plusquam/PlusqMoCap_HW/doc/STM32WB/MB1355C Mechanical Dimension.jpg

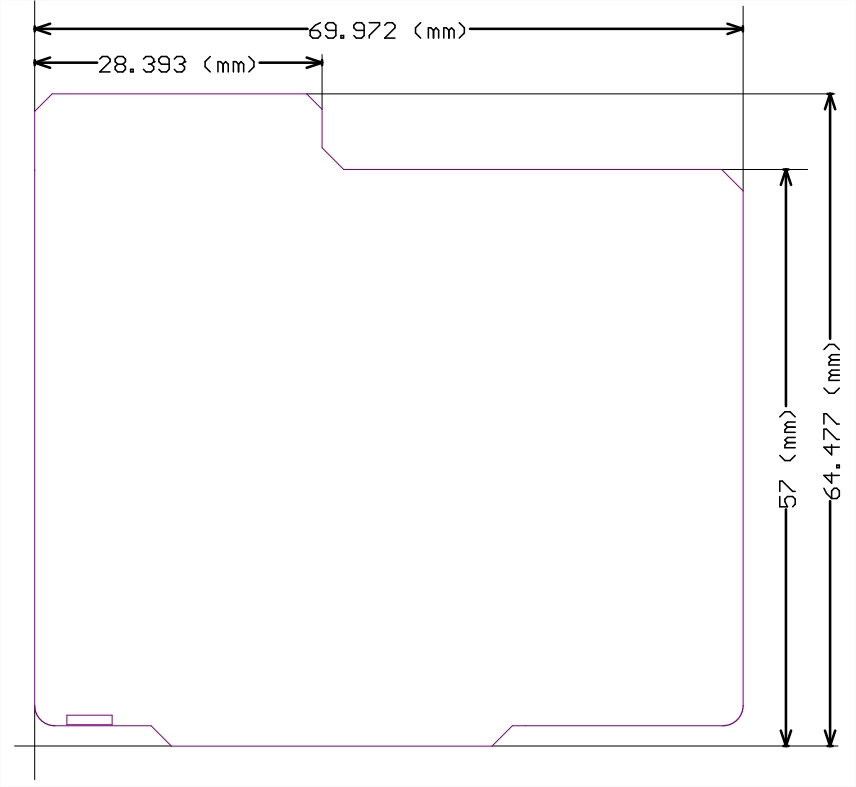
doc/STM32WB/MB1355C Mechanical Dimension.jpg
