plusquam/PlusqMoCap_HW/BOM/main_board_BOM.xlsx

 |  |  | Main Board BOM
Item # | *Ref Des | *Qty | Manufacturer | *Mfg Part # | Description / Value | *Package | Type | Your Instructions / Notes
1 | C1,C2,C3,C4,C5 | 5 | VISHAY | VJ1206V475MXQTW1BC | Ceramic Capacitor, 4.7 µF, Y5V, 10 V | C1206 | SMD | (any/open) Any cheapest and available part which match specification.
2 | D2 | 1 | Vishay | VS-10BQ015-M3/5BT | VS-10BQ015-M3/5BT Vishay SMT Schottky Diode, 15V 1A, 2-Pin DO-214AA (SMB) | DO-214AA | SMD
3 | IC1 | 1 | Microchip | MCP73831T-2ACI/OT | Li-Ion Charge Controller 4.2V SOT23-5 | SOT-23 | SMD
4 | JP1,JP2 | 2 | MULTICOMP | 2212SM-04G-75-B1-PCR | Female pin header (socket), 1x4 slots, pitch 2,54mm | 1X04SMD | SMD | Given device is only example device, it can be replaced with any cheaper and available part which match specification.
5 | L1 | 1 | Bourns | SRN2512-2R2M | Bourns SRN2512 Series Shielded Wire-wound SMD Inductor with a Ferrite Core, 2.2 uH +/-20% 2.3A Idc | INDPM2622X120N | SMD | Given device is only example device, it can be replaced with any cheaper and available part which match specification.
6 | LED1 | 1 | KINGBRIGHT | KPT-3216SGC | Green LED in 1206 package, If = 20mA, Vf = 2,2V | 1206 | SMD | Given device is only example device, it can be replaced with any cheaper and available part which match specification.
7 | R1 | 1 |  |  | 100kOhm, Thick Film Chip Resistor, 1% tolerance, Max. Dissipation 250mW | R1206 | SMD | (any/open) Any cheapest and available part which match specification.
8 | R2,R5 | 2 |  |  | 10kOhm, Thick Film Chip Resistor, 1% tolerance, Max. Dissipation 250mW | R1206 | SMD | (any/open) Any cheapest and available part which match specification.
9 | R3 | 1 |  |  | 150Ohm, Thick Film Chip Resistor, 1% tolerance, Max. Dissipation 250mW | R1206 | SMD | (any/open) Any cheapest and available part which match specification.
10 | R4 | 1 |  |  | 402kOhm, Thick Film Chip Resistor, 1% tolerance, Max. Dissipation 250mW | R1206 | SMD | (any/open) Any cheapest and available part which match specification.
11 | S1 | 1 | EOZ | 09.03201.02 | 2 Way Through Hole SIP Switch SPST, 500mA, 12Vdc | 3POS | thru-hole | Given device is only example device, it can be replaced with any cheaper and available part which match specification.
12 | U$2 | 1 | TEXAS INSTRUMENTS | TLV62568DRLT | DC-DC buck converter | SOT563 | SMD
13 | U$4 | 1 | AMP - TE CONNECTIVITY | 1-2178711-0 | Headers & Wire Housings FOB, SMD, 10P, Pitch: 1,27mm | 2x5POS | SMD | Given device is only example device, it can be replaced with any cheaper and available part which match specification.
14 | U$5 | 1 | NEXPERIA | 74AHC126D,118 | Buffers & Line Drivers QUAD 3-STATE BUS BUF | SOIC-14 | SMD | Given device is only example device, it can be replaced with any cheaper and available part which match specification.
15 | CN7,CN10 | 2 |  |  | Female pin header (socket), 2x19 (38) slots, pitch 2,54mm | 2X19SMD | SMD | (any/open) Any cheapest and available part which match specification.
 | SUM | 22
