plusquam/PlusqMoCap_HW/case/Main board/Main_Board_Top.stl

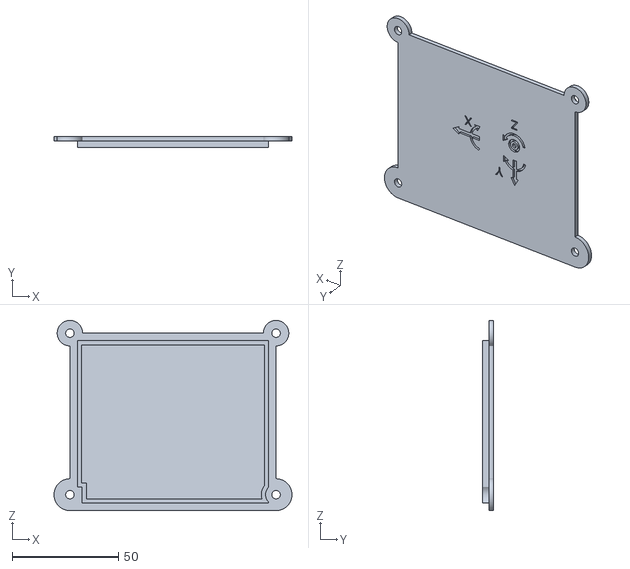
[picture p2: CAD file, 2019-09-26]
case/Main board/Main_Board_Top.stl
112.0 x 5.00 x 89.5
