plusquam/PlusqMoCap_HW/case/Main board/CCR10S_Main_Board.3mf

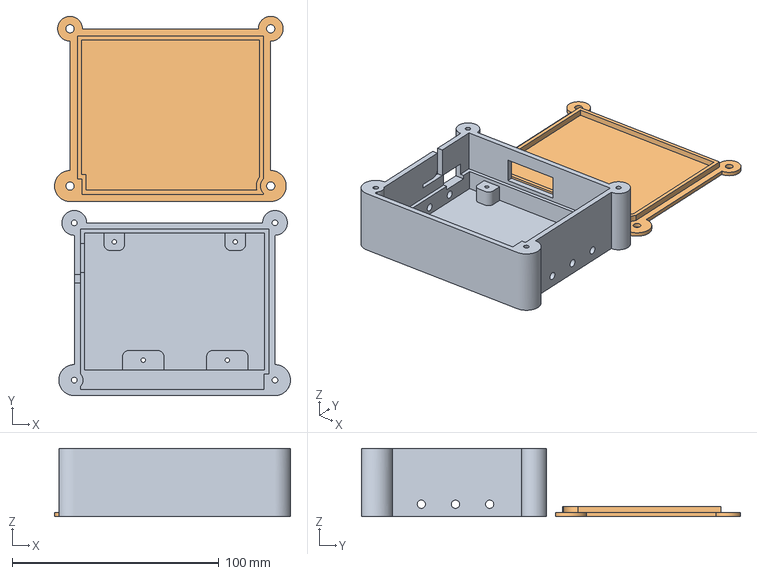
[picture p3: CAD file, 2019-09-26]
case/Main board/CCR10S_Main_Board.3mf
114.1 x 183.3 x 33.0 mm
