plusquam/PlusqMoCap_HW/case/Main board/Main_Board_Bottom.stl

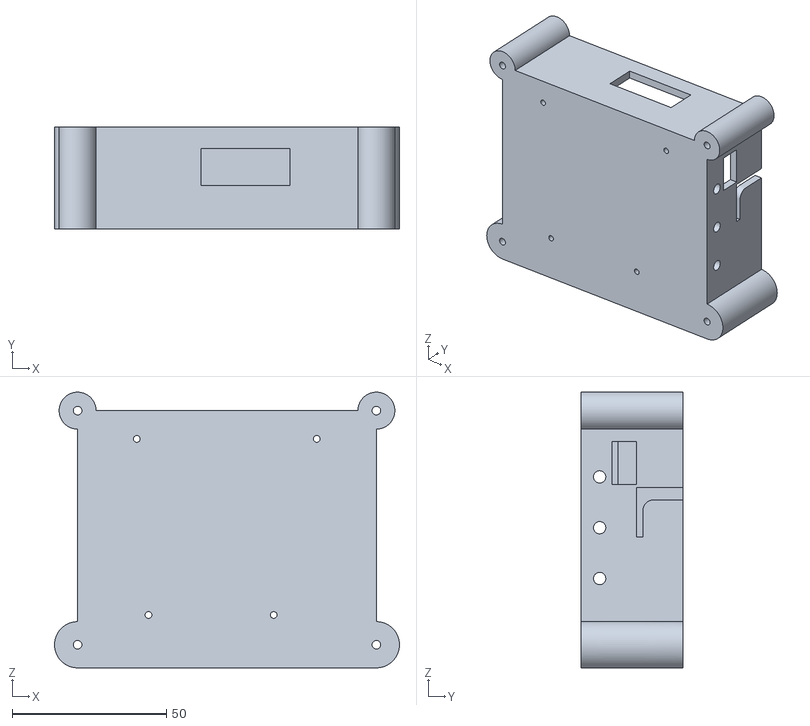
[picture p4: CAD file, 2019-09-26]
case/Main board/Main_Board_Bottom.stl
112.0 x 33.0 x 89.5
