plusquam/PlusqMoCap_HW/case/Sensor board/Sensor_Board_Top.stl

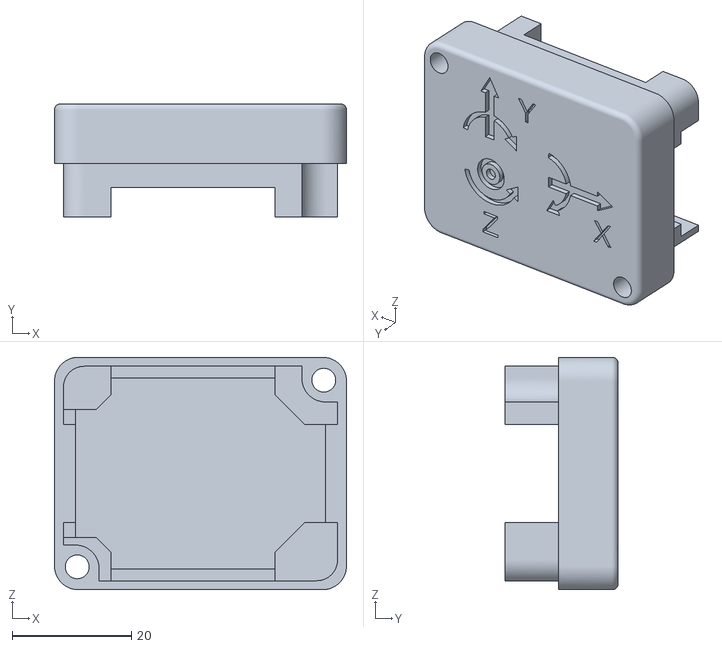
[picture p5: CAD file, 2019-09-26]
case/Sensor board/Sensor_Board_Top.stl
49.0 x 19.0 x 39.0
