plusquam/PlusqMoCap_HW/case/Sensor board/Sensor_Board_Bottom.stl

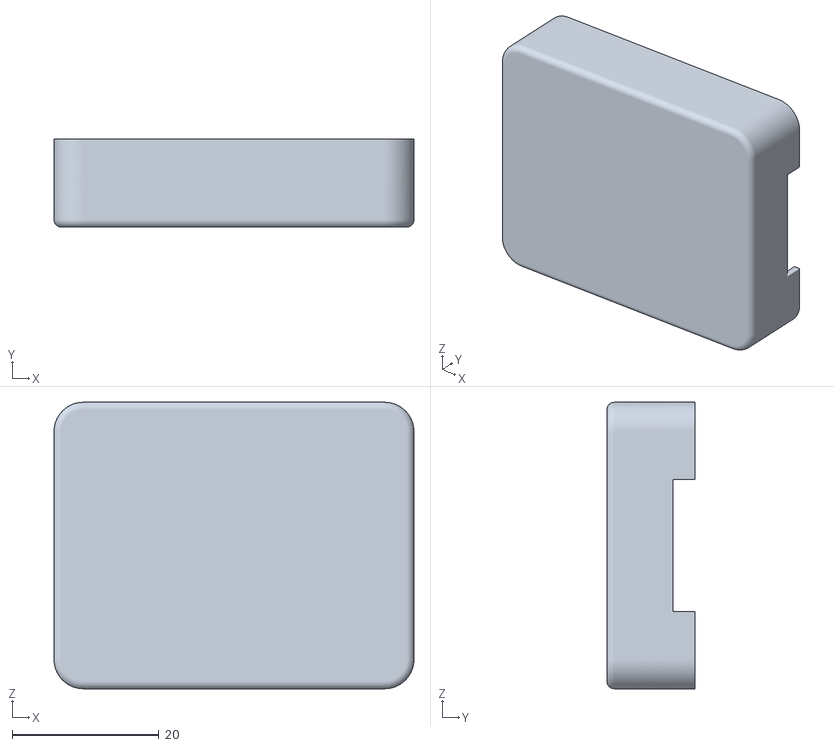
[picture p6: CAD file, 2019-09-26]
case/Sensor board/Sensor_Board_Bottom.stl
49.0 x 12.0 x 39.0
