plusquam/PlusqMoCap_HW/case/Sensor board/CCR10S_Sensor_Board.3mf

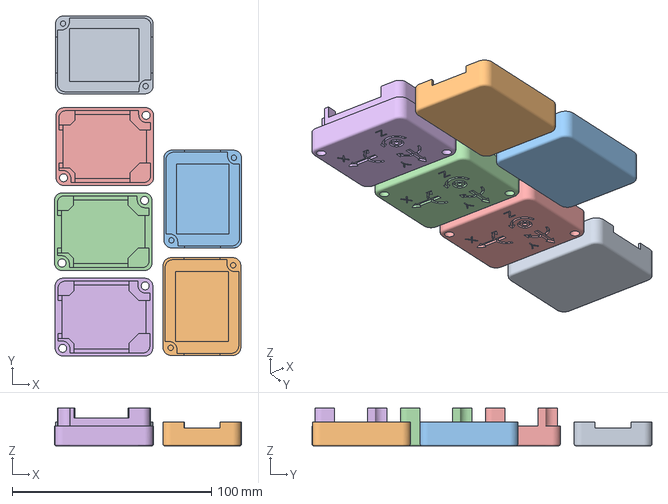
[picture p7: CAD file, 2019-09-26]
case/Sensor board/CCR10S_Sensor_Board.3mf
93.8 x 170.4 x 19.0 mm
