plusquam/PlusqMoCap_HW/(list of files, cad)

Other CAD files:
case/Main board/Main_Board_Box v1.f3d
case/Sensor board/Sensor_Board_Box v9.f3d
