plusquam/PlusqMoCap_HW/sch/nrf51822_board.pdf

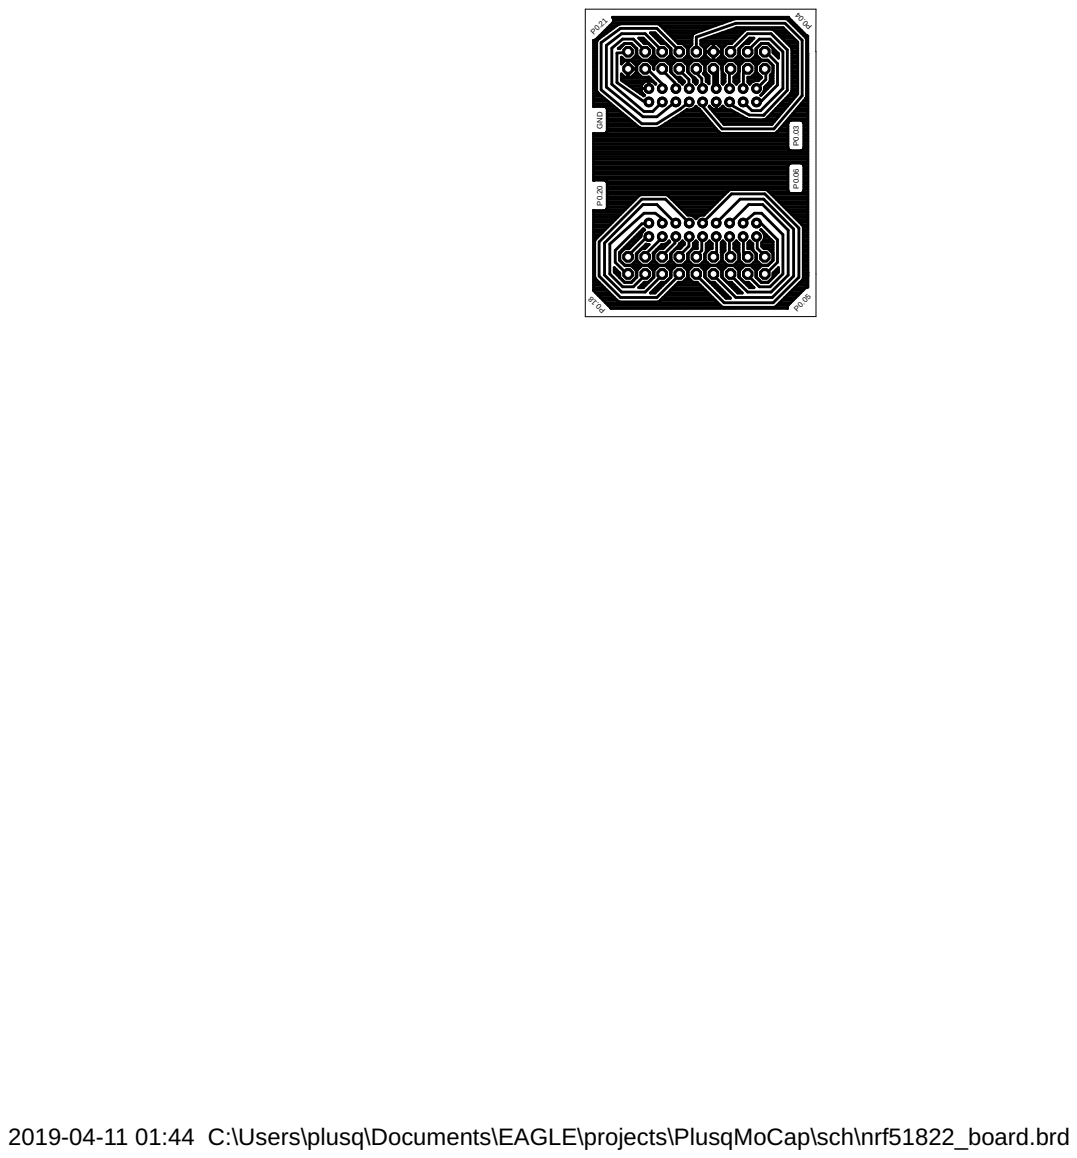
[picture p8: page 1]

2019-04-11 01:44 C:\Users\plusq\Documents\EAGLE\projects\PlusqMoCap\sch\nrf51822_board.brd
