plusquam/PlusqMoCap_HW/sch/main_board.brd

## EAGLE design sch/main_board.brd (2019-09-13)

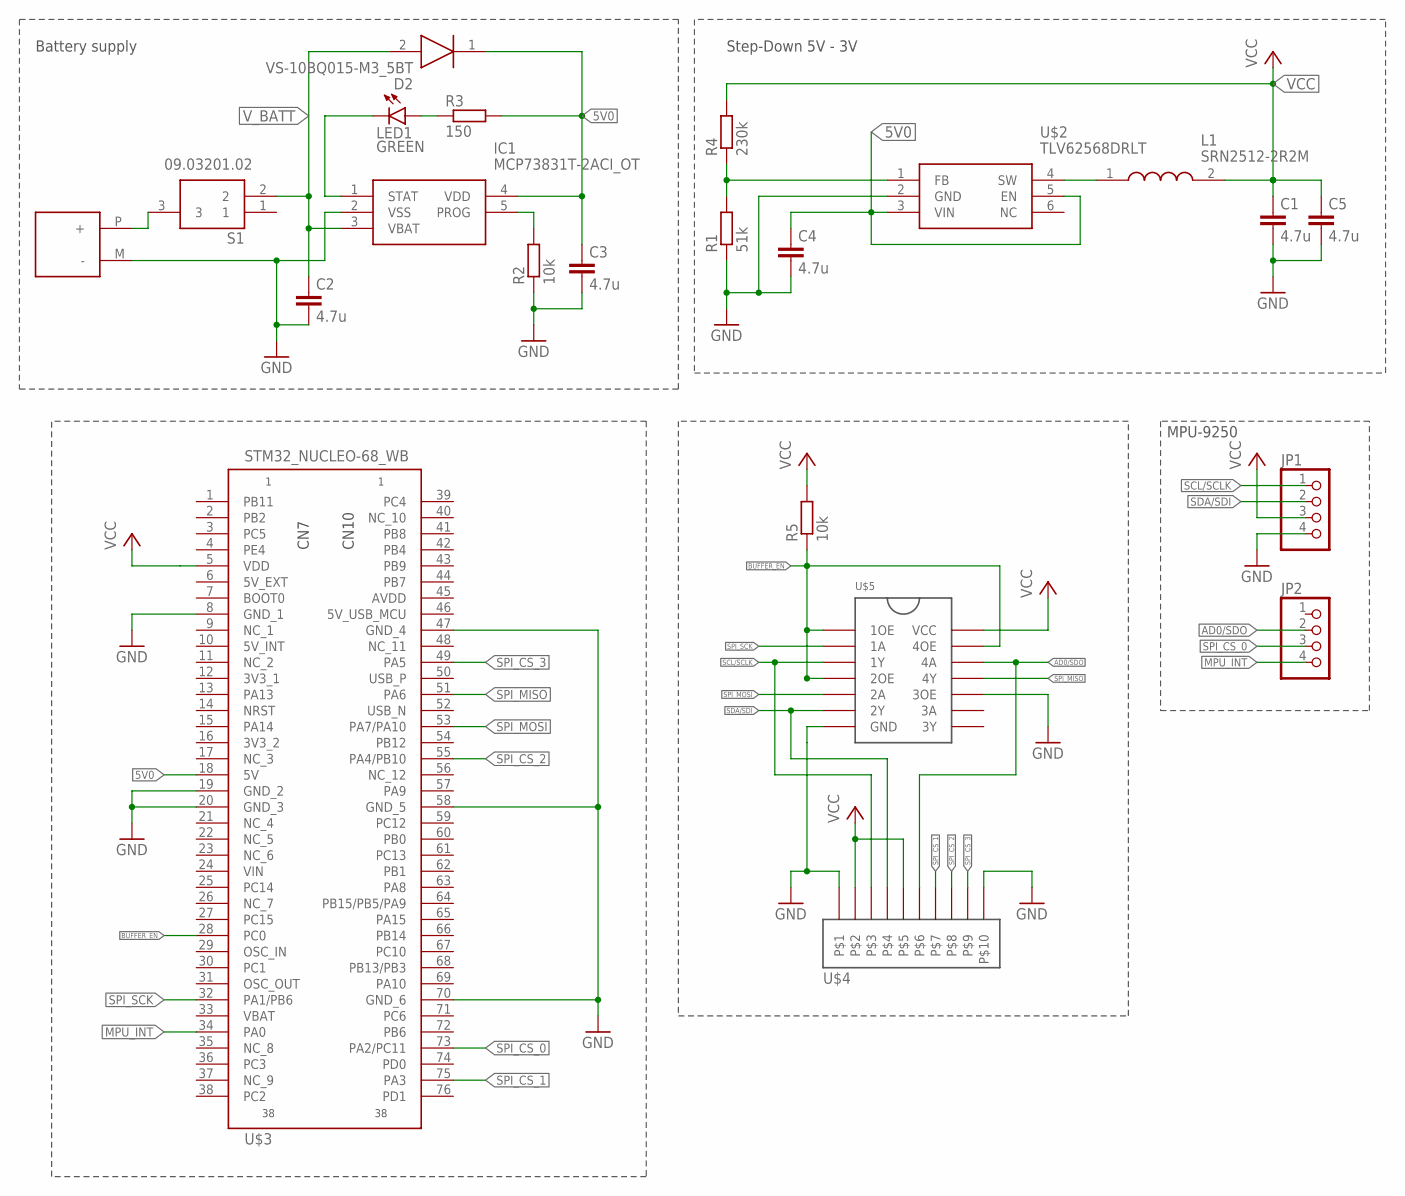
[picture p9: schematic main_board.sch]

Parts:
C1, C2, C3, C4, C5: 4.7u; C1206
D2: VS-10BQ015-M3_5BT; DIOM5436X244N
IC1: MCP73831T-2ACI_OT; SOT95P270X145-5N
JP1, JP2: PINHD-1X04_2.54-SMD; 1X04SMD
L1: SRN2512-2R2M; INDPM2622X120N
LED1: GREEN; CHIPLED_1206
R1: 51k; R1206
R2, R5: 10k; R1206
R3: 150; R1206
R4: 230k; R1206
S1: 09.03201.02; 090320102
U$1: BAT_FLAT_PAD; BATTERY_FLAT_PAD
U$2: TLV62568DRLT; SOT563
U$3: STM32_NUCLEO-68_WB; STM32_NUCLEO-68_FOOTPRINT
U$4: 1-2178711-2; 1-2178712-0
U$5: 74AHC126D,118; SOIC127P600X175-14N

Connections:
5V0: C3.1, C4.1, D2.1 (K), IC1.4 (VDD), R3.2, U$2.3 (VIN), U$2.5 (EN), U$3.18 (5V)
AD0/SDO: JP2.2, U$4.P$6, U$5.12 (4A)
BUFFER_EN: R5.1, U$3.28 (PC0), U$5.1 (1OE), U$5.4 (2OE), U$5.13 (4OE)
GND: C1.2, C2.2, C3.2, C4.2, C5.2, IC1.2 (VSS), JP1.4, R1.1, R2.1, U$1.M (-), U$2.2 (GND), U$3.8 (GND_1), U$3.19 (GND_2), U$3.20 (GND_3), U$3.47 (GND_4), U$3.58 (GND_5), U$3.70 (GND_6), U$4.P$1, U$4.P$10, U$5.7 (GND), U$5.10 (3OE)
MPU_INT: JP2.4, U$3.34 (PA0)
unnamed: LED1.A, R3.1
unnamed: IC1.1 (STAT), LED1.C
unnamed: IC1.5 (PROG), R2.2
unnamed: S1.3, U$1.P (+)
unnamed: L1.1, U$2.4 (SW)
unnamed: R1.2, R4.1, U$2.1 (FB)
SCL/SCLK: JP1.1, U$4.P$3, U$5.3 (1Y)
SDA/SDI: JP1.2, U$4.P$4, U$5.6 (2Y)
SPI_CS_0: JP2.3, U$3.73 (PA2/PC11)
SPI_CS_1: U$3.75 (PA3), U$4.P$7
SPI_CS_2: U$3.55 (PA4/PB10), U$4.P$8
SPI_CS_3: U$3.49 (PA5), U$4.P$9
SPI_MISO: U$3.51 (PA6), U$5.11 (4Y)
SPI_MOSI: U$3.53 (PA7/PA10), U$5.5 (2A)
SPI_SCK: U$3.32 (PA1/PB6), U$5.2 (1A)
VCC: C1.1, C5.1, JP1.3, L1.2, R4.2, R5.2, U$3.5 (VDD), U$4.P$2, U$4.P$5, U$5.14 (VCC)
V_BATT: C2.1, D2.2 (A), IC1.3 (VBAT), S1.2

Notes on the sheet:
Step-Down 5V - 3V
Battery supply
MPU-9250

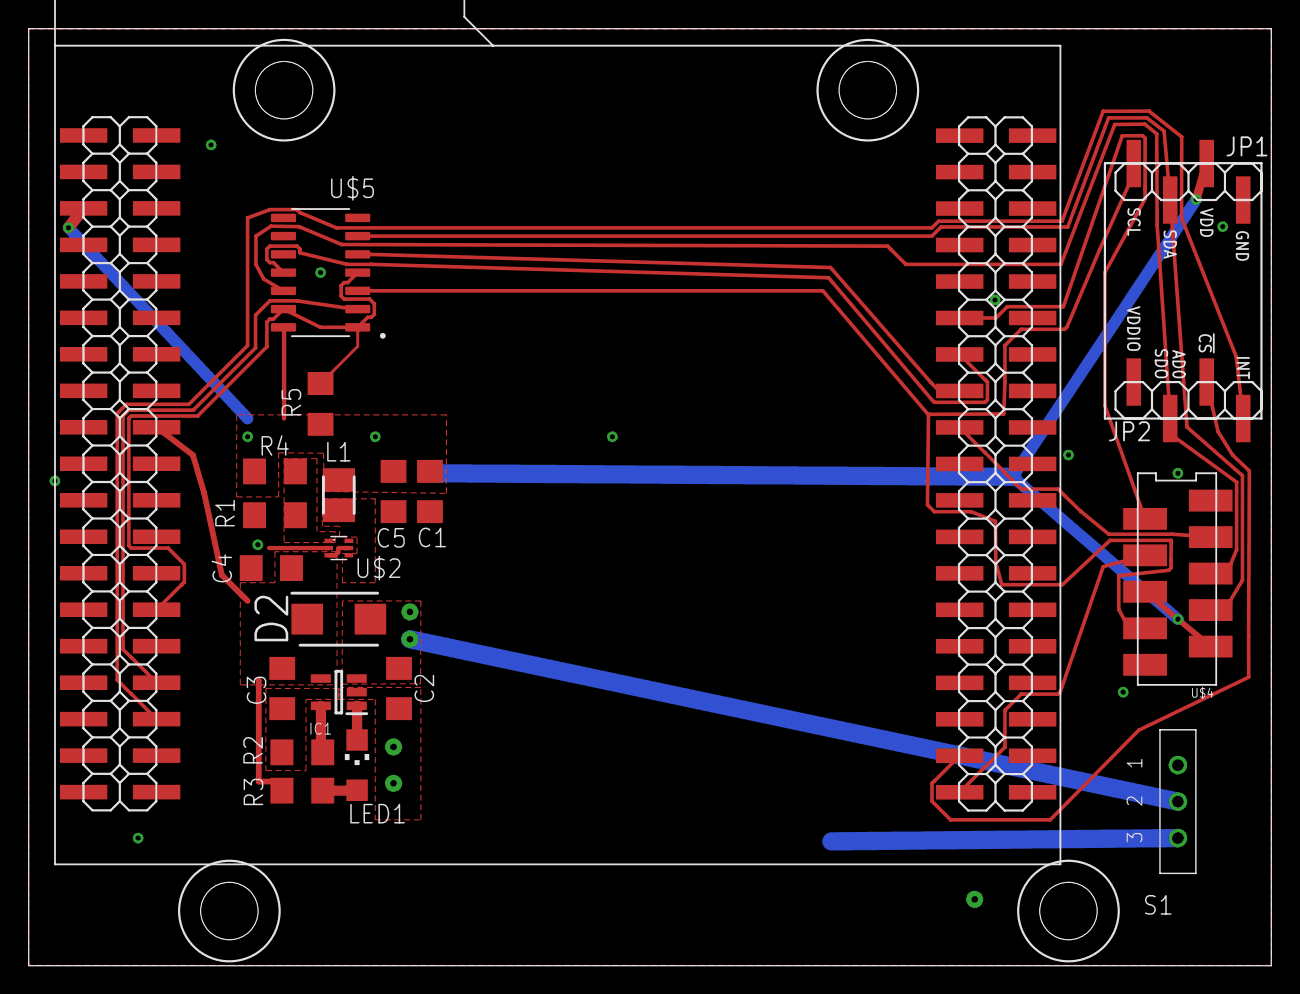
[picture p10: board main_board.brd from above]

Board: 2 copper layers, 86.5 x 65.2 mm, 22 parts (1 on the bottom side), 22 nets.
