plusquam/PlusqMoCap_HW/sch/sensor_board.brd

## EAGLE design sch/sensor_board.brd (2019-08-21)

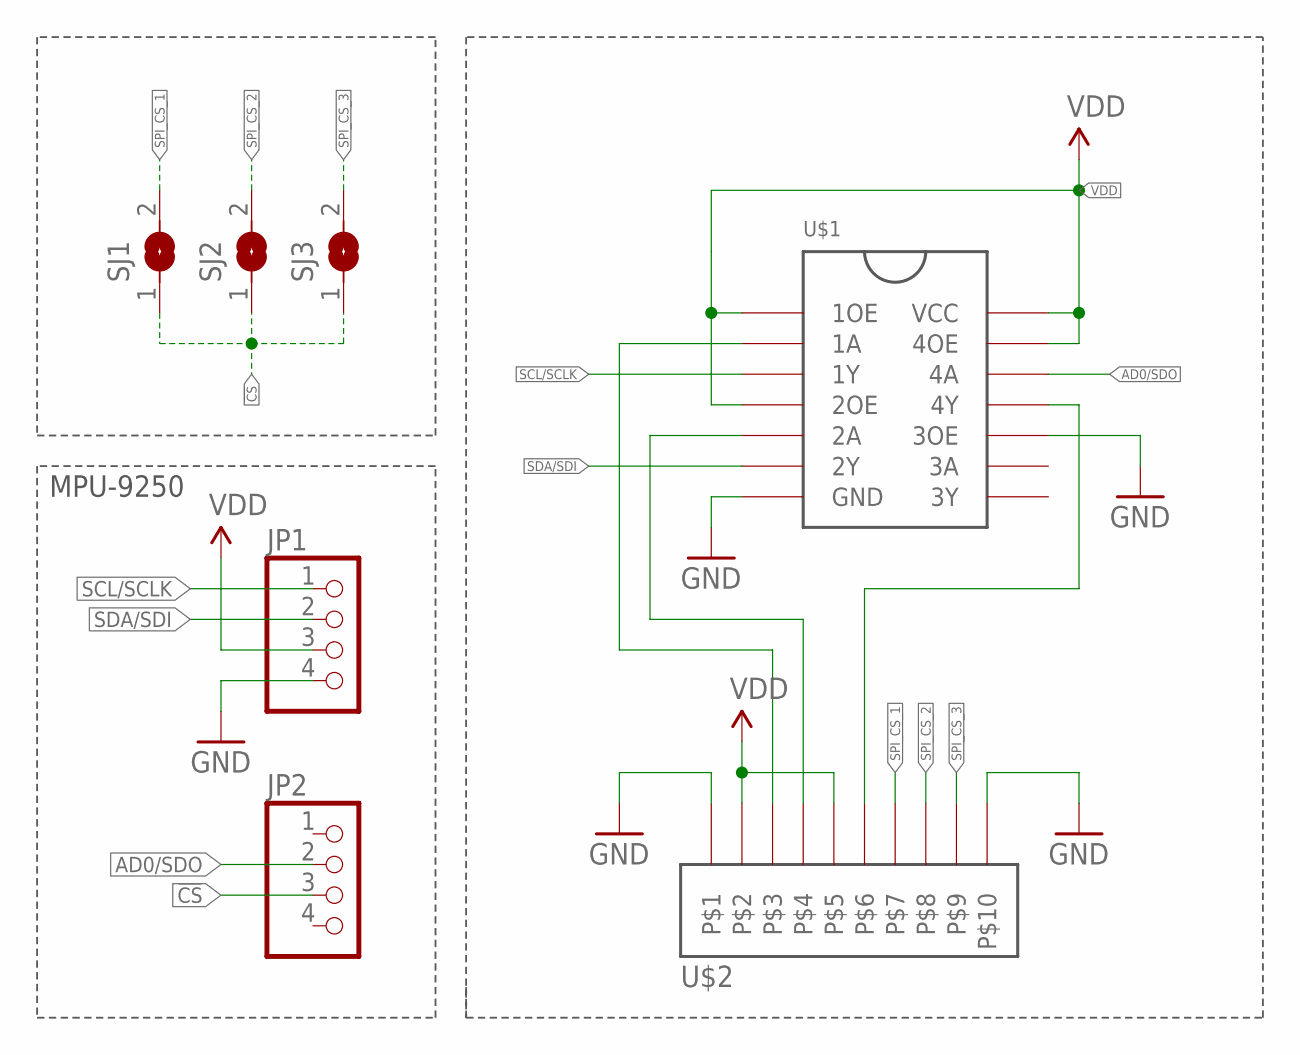
[picture p11: schematic sensor_board.sch]

Parts:
JP1, JP2: PINHD-1X04_2.54-SMD; 1X04SMD
SJ1, SJ2, SJ3: SJ
U$1: 74AHC126D,118; SOIC127P600X175-14N
U$2: 1-2178711-2; 1-2178712-0

Connections:
!CS: JP2.3, SJ1.1, SJ2.1, SJ3.1
AD0/SDO: JP2.2, U$1.12 (4A)
GND: JP1.4, U$1.7 (GND), U$1.10 (3OE), U$2.P$1, U$2.P$10
unnamed: U$1.2 (1A), U$2.P$3
unnamed: U$1.11 (4Y), U$2.P$6
unnamed: U$1.5 (2A), U$2.P$4
SCL/SCLK: JP1.1, U$1.3 (1Y)
SDA/SDI: JP1.2, U$1.6 (2Y)
SPI_CS_1: SJ1.2, U$2.P$7
SPI_CS_2: SJ2.2, U$2.P$8
SPI_CS_3: SJ3.2, U$2.P$9
VDD: JP1.3, U$1.1 (1OE), U$1.4 (2OE), U$1.13 (4OE), U$1.14 (VCC), U$2.P$2, U$2.P$5

Notes on the sheet:
MPU-9250

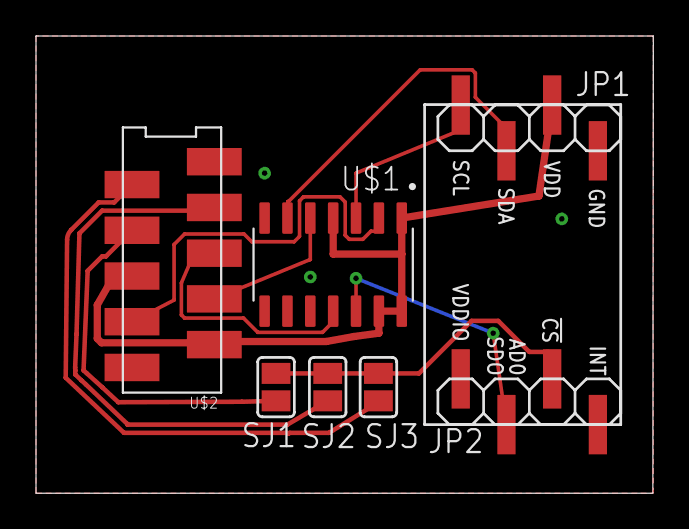
[picture p12: board sensor_board.brd from above]

Board: 2 copper layers, 34.3 x 25.4 mm, 7 parts (0 on the bottom side), 12 nets.
