plusquam/PlusqMoCap_HW/sch/nrf51822_board.brd

## EAGLE design sch/nrf51822_board.brd (2019-05-17)

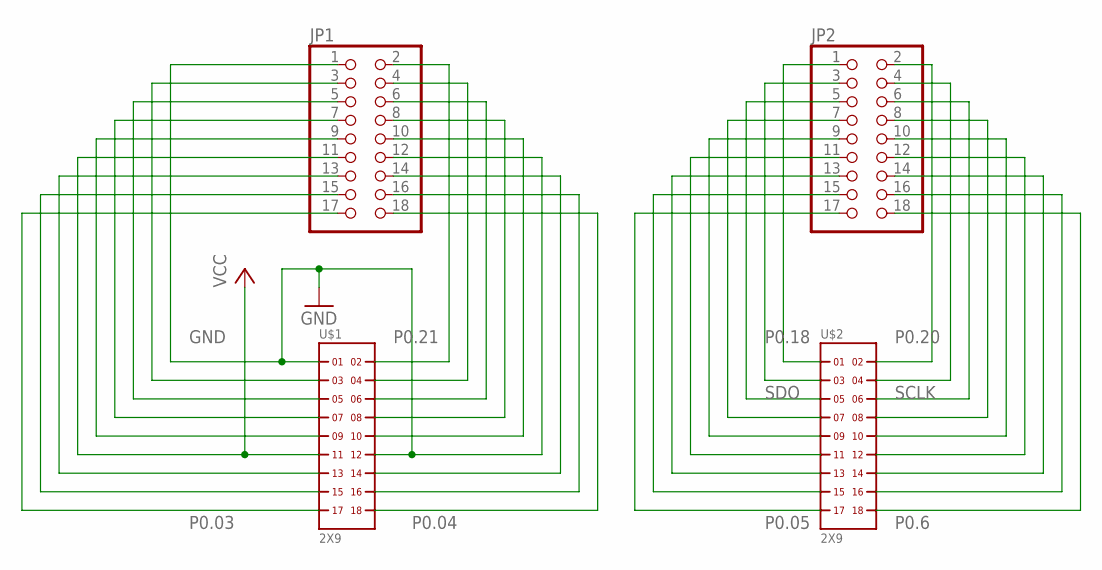
[picture p13: schematic nrf51822_board.sch]

Parts:
JP1, JP2: PINHD-2X9; 2X09
U$1, U$2: 2X9

Connections:
GND: JP1.1, JP1.12, U$1.1, U$1.12
unnamed: JP1.3, U$1.3
unnamed: JP1.5, U$1.5
unnamed: JP1.7, U$1.7
unnamed: JP1.9, U$1.9
unnamed: JP1.13, U$1.13
unnamed: JP1.15, U$1.15
unnamed: JP1.4, U$1.4
unnamed: JP1.6, U$1.6
unnamed: JP1.8, U$1.8
unnamed: JP1.10, U$1.10
unnamed: JP1.14, U$1.14
unnamed: JP1.16, U$1.16
unnamed: JP2.3, U$2.3
unnamed: JP2.7, U$2.7
unnamed: JP2.9, U$2.9
unnamed: JP2.11, U$2.11
unnamed: JP2.13, U$2.13
unnamed: JP2.15, U$2.15
unnamed: JP2.4, U$2.4
unnamed: JP2.8, U$2.8
unnamed: JP2.10, U$2.10
unnamed: JP2.12, U$2.12
unnamed: JP2.14, U$2.14
unnamed: JP2.16, U$2.16
P0.03: JP1.17, U$1.17
P0.04: JP1.18, U$1.18
P0.05: JP2.17, U$2.17
P0.6: JP2.18, U$2.18
P0.18: JP2.1, U$2.1
P0.20: JP2.2, U$2.2
P0.21: JP1.2, U$1.2
SCLK: JP2.6, U$2.6
SDO: JP2.5, U$2.5
VCC: JP1.11, U$1.11

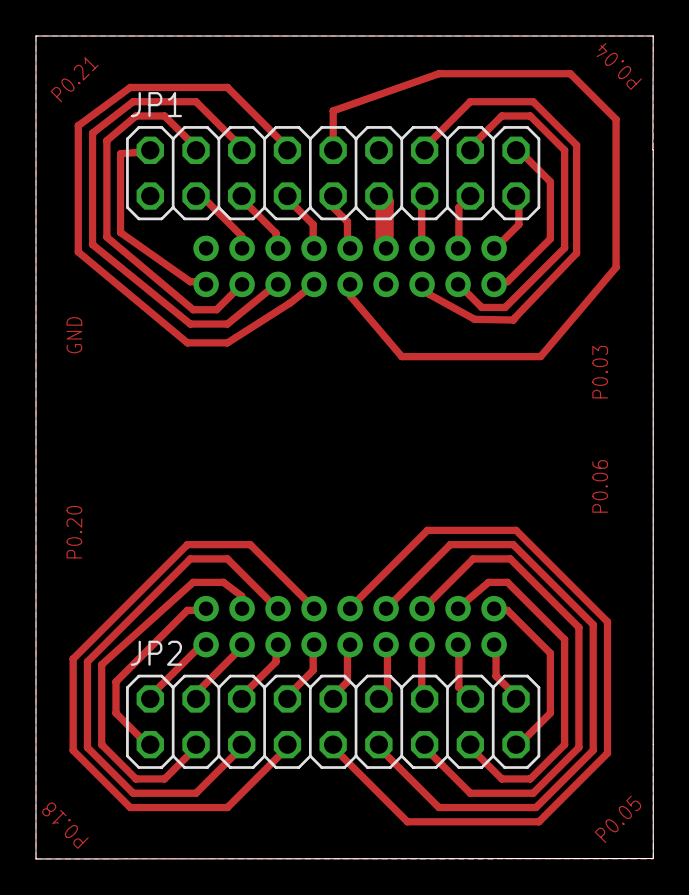
[picture p14: board nrf51822_board.brd from above]

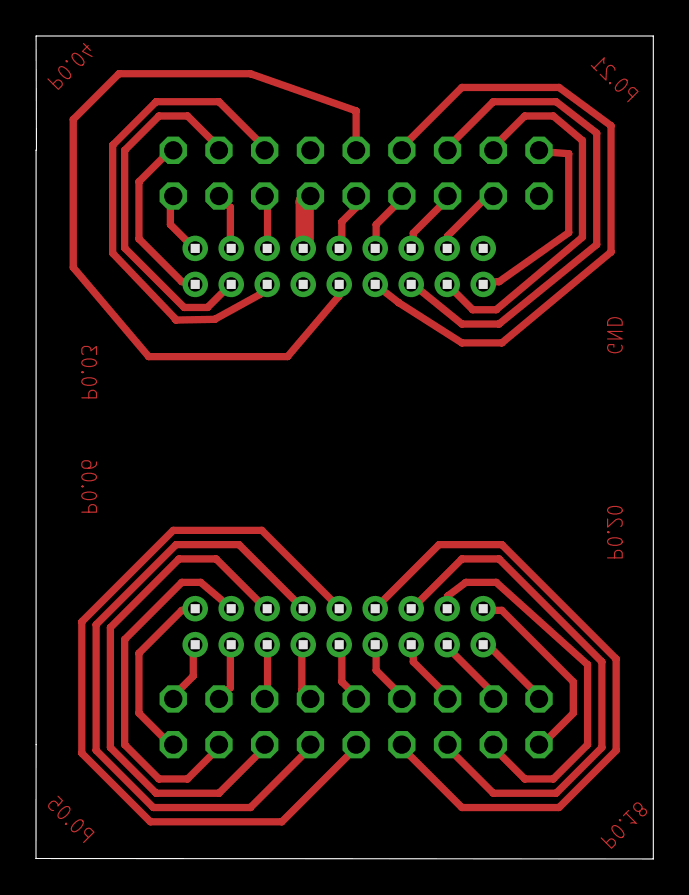
[picture p15: board nrf51822_board.brd from below]

Board: 2 copper layers, 34.3 x 45.7 mm, 4 parts (2 on the bottom side), 35 nets.
