plusquam/PlusqMoCap_HW/sch/SparkFun_MPU-9250_Breakout.brd

## EAGLE design sch/SparkFun_MPU-9250_Breakout.brd (2019-05-17)


Parts:
C1, C2: 0.1uF; 0603-CAP
FID1, FID2: FIDUCIAL1X2; FIDUCIAL-1X2
FRAME1: FRAME-LETTER; CREATIVE_COMMONS
J1, J3: M04PTH; 1X04
J2: M03PTH; 1X03
LOGO1: SFE_LOGO_FLAME.1_INCH; SFE_LOGO_FLAME_.1
LOGO2: OSHW-LOGOS; OSHW-LOGO-S
R1, R2, R3: 10K; 0603-RES
SJ1: JUMPER-PAD-2-NC_BY_PASTEFULL-BOX-SILK; PAD-JUMPER-2-NC_BY_PASTE_YES_SILK_FULL_BOX
SJ2: JUMPER_PAD-3-1&2_NC_BY_PASTE; PAD-HUMPER-3-1&2_NC_BY_PASTE_YES_SILK_FULL_BOX
STANDOFF1, STANDOFF2: STAND-OFF
U1: MPU-9250; QFN24_PAD

Connections:
!CS: J3.3, R3.1, U1.22 (!CS)
AD0/SDO: J3.2, SJ2.3
ADSD_STUB: SJ2.2, U1.9 (AD0/SDO)
AUX_CL: J2.1, U1.7 (AUX_CL)
AUX_DA: J2.3, U1.21 (AUX_DA)
FSYNC: J2.2, U1.11 (FSYNC)
GND: C1.2, C2.2, J1.4, SJ2.1, U1.18 (GND), U1.20 (GND), U1.CENTER (GND)
INT: J3.4, U1.12 (INT)
REGOUT: C1.1, U1.10 (REGOUT)
SCL/SCLK: J1.1, R2.1, U1.23 (SCL/SCLK)
SDA/SDI: J1.2, R1.1, U1.24 (SDA/SDI)
VDD: C2.1, J1.3, SJ1.1, U1.13 (VDD)
VDDIO: J3.1, R1.2, R2.2, R3.2, SJ1.2, U1.1 (VDDIO), U1.8 (VDDIO)

Notes on the sheet:
AD0/SDO defaults to 0V. This sets the I2C address to 0b1101000 (0x68) and leaves the AD0/SDO PTH disconnected. Connect to AD0/SD0 PTH to change externally. Pull high to set address to 0b1101001 (0x69).
AD0 sets LSB of address
Set VDD and VDDIO equal by default
VDD 2.4 to 3.6 V VDDIO 1.71 to VDD



Board: 2 copper layers, 17.0 x 17.8 mm, 18 parts (2 on the bottom side), 13 nets.
