plusquam/PlusqMoCap_HW/(commit log)

2019-05-17 Import source files from PlusqMoCap repo.
    [DRILEGEND.CFG, SparkFun_MPU-9250_Breakout.brd, SparkFun_MPU-9250_Breakout.sch, core51822_pinout.brd, core51822_pinout.sch, main_board.brd, main_board.sch, nrf51822_board.brd]
2019-07-08 Add docs for STM32WB, Remove unused power supply elements.
    [main_board.brd, main_board.sch]
2019-07-09 Add library for STM32WB prototype board.
    [main_board.brd, main_board.sch]
2019-08-14 Add STM32WB board part, add sensor connector part
    [main_board.brd, main_board.sch]
2019-08-16 Main board ver. 1.0
    [MPU-9250_board_plug.brd, MPU-9250_board_plug.sch, main_board.brd, main_board.csv, main_board.sch]
2019-08-21 Ready for production HW version
    [BOM.xlsx, main_board.brd, main_board.csv, main_board.sch, main_board_BOM.xlsx, sensor_board.brd, sensor_board.sch, sensor_board_BOM.xlsx]
2019-09-13 Add BOM files
    [main_board_BOM.xlsx, sensor_board_BOM.xlsx]
2019-09-13 Change feedback resistors for DC/DC converter
    [main_board.brd, main_board.sch]
2019-09-15 Update schematic documentation
    [main_board.sch]
2019-09-26 Add cases design and CAM files
    [CCR10S_Main_Board.3mf, CCR10S_Sensor_Board.3mf, Main_Board_Bottom.stl, Main_Board_Box v1.f3d, Main_Board_Top.stl, Sensor_Board_Bottom.stl, Sensor_Board_Box v9.f3d, Sensor_Board_Top.stl]
